jasobrino/sensores-MQTT/modulos lora/estacion/README.md

# sensores-MQTT
recopilación datos a través de mqtt
