jasobrino/sensores-MQTT/documentos/Schematic_ESP32 sensores MQTT rev. 1.2_2023-10-23.png

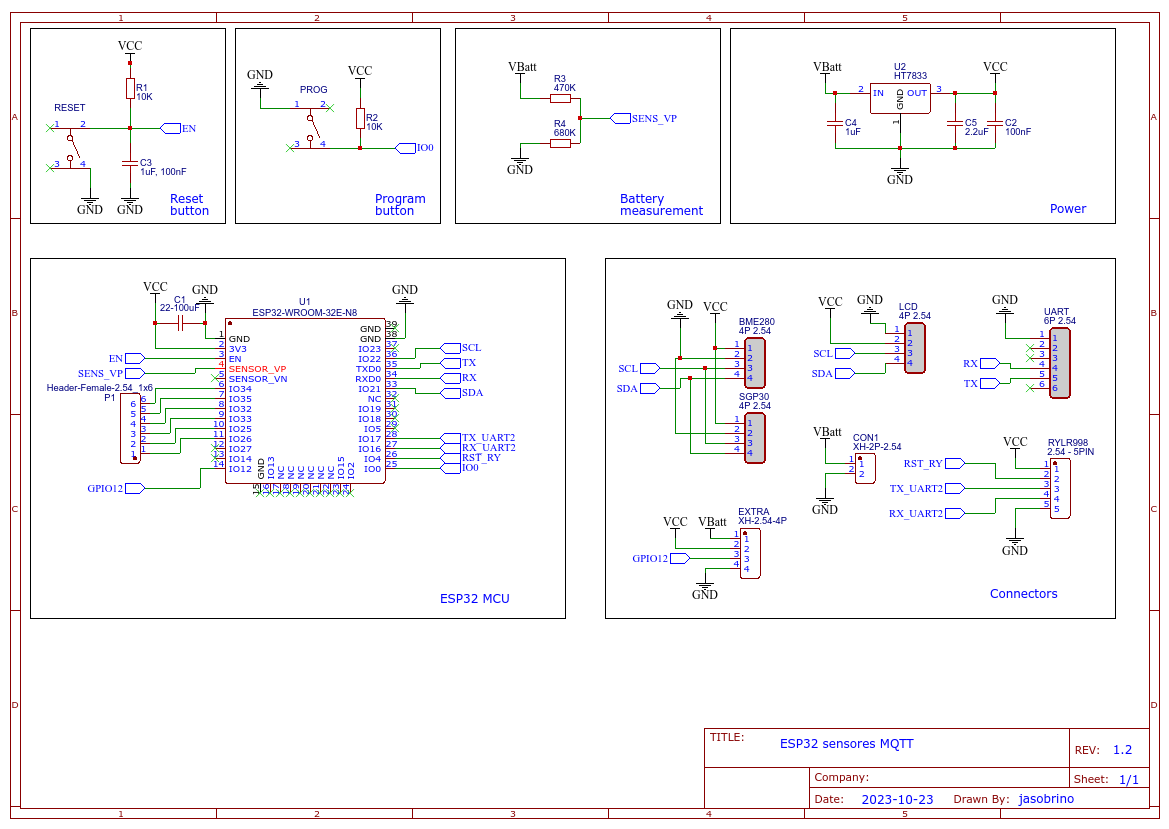
documentos/Schematic_ESP32 sensores MQTT rev. 1.2_2023-10-23.png
