jasobrino/sensores-MQTT/documentos/Gerber_PCB_ESP32 BME280 V1.0 2023-05-28/How-to-order-PCB.txt

How to Order PCB

Please refer to:
https://docs.easyeda.com/en/PCB/Order-PCB
