jasobrino/sensores-MQTT/documentos/datos_tester_rssi-57.pdf

Test Data

2023-05-09 16:33:21

1/8

No. | Date/Time | Function | Range | Value | Unit
1 | 2023-05-09 16:30:41 | DCA | 22 | 0.000 | A
2 | 2023-05-09 16:30:42 | DCA | 22 | 0.000 | A
3 | 2023-05-09 16:30:42 | DCA | 22 | 0.000 | A
4 | 2023-05-09 16:30:42 | DCA | 22 | 0.000 | A
5 | 2023-05-09 16:30:42 | DCA | 22 | 0.000 | A
6 | 2023-05-09 16:30:42 | DCA | 22 | 0.000 | A
7 | 2023-05-09 16:30:43 | DCA | 22 | 0.000 | A
8 | 2023-05-09 16:30:43 | DCA | 22 | 0.000 | A
9 | 2023-05-09 16:30:43 | DCA | 22 | 0.000 | A
10 | 2023-05-09 16:30:43 | DCA | 22 | 0.000 | A
11 | 2023-05-09 16:30:44 | DCA | 22 | 0.000 | A
12 | 2023-05-09 16:30:44 | DCA | 22 | 0.000 | A
13 | 2023-05-09 16:30:44 | DCA | 22 | 0.000 | A
14 | 2023-05-09 16:30:44 | DCA | 22 | 0.000 | A
15 | 2023-05-09 16:30:44 | DCA | 22 | 0.000 | A
16 | 2023-05-09 16:30:45 | DCA | 22 | 0.000 | A
17 | 2023-05-09 16:30:45 | DCA | 22 | 0.000 | A
18 | 2023-05-09 16:30:45 | DCA | 22 | 0.000 | A
19 | 2023-05-09 16:30:45 | DCA | 22 | 0.000 | A
20 | 2023-05-09 16:30:46 | DCA | 22 | 0.000 | A
21 | 2023-05-09 16:30:46 | DCA | 22 | 0.000 | A
22 | 2023-05-09 16:30:46 | DCA | 22 | 0.000 | A
23 | 2023-05-09 16:30:46 | DCA | 22 | 0.000 | A
24 | 2023-05-09 16:30:46 | DCA | 22 | 0.000 | A
25 | 2023-05-09 16:30:47 | DCA | 22 | 0.000 | A
26 | 2023-05-09 16:30:47 | DCA | 22 | 0.000 | A
27 | 2023-05-09 16:30:47 | DCA | 22 | 0.000 | A
28 | 2023-05-09 16:30:47 | DCA | 22 | 0.000 | A
29 | 2023-05-09 16:30:47 | DCA | 22 | 0.000 | A
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
481 | 2023-05-09 16:32:27 | DCA | 22 | 0.000 | A
482 | 2023-05-09 16:32:27 | DCA | 22 | 0.000 | A
483 | 2023-05-09 16:32:27 | DCA | 22 | 0.000 | A
484 | 2023-05-09 16:32:27 | DCA | 22 | 0.000 | A
485 | 2023-05-09 16:32:27 | DCA | 22 | 0.000 | A
486 | 2023-05-09 16:32:28 | DCA | 22 | 0.000 | A
487 | 2023-05-09 16:32:28 | DCA | 22 | 0.000 | A
488 | 2023-05-09 16:32:28 | DCA | 22 | 0.000 | A
489 | 2023-05-09 16:32:28 | DCA | 22 | 0.000 | A
490 | 2023-05-09 16:32:29 | DCA | 22 | 0.000 | A
491 | 2023-05-09 16:32:29 | DCA | 22 | 0.000 | A
492 | 2023-05-09 16:32:29 | DCA | 22 | 0.000 | A
493 | 2023-05-09 16:32:29 | DCA | 22 | 0.000 | A
494 | 2023-05-09 16:32:29 | DCA | 22 | 0.000 | A
495 | 2023-05-09 16:32:30 | DCA | 22 | 0.000 | A
496 | 2023-05-09 16:32:30 | DCA | 22 | 0.000 | A
497 | 2023-05-09 16:32:30 | DCA | 22 | 0.000 | A
498 | 2023-05-09 16:32:30 | DCA | 22 | 0.000 | A
499 | 2023-05-09 16:32:31 | DCA | 22 | 0.000 | A
500 | 2023-05-09 16:32:31 | DCA | 22 | 0.000 | A
