jasobrino/sensores-MQTT/(commit log)

2023-11-28 divido proyecto en receptor y estacion
    [Drill_NPTH_Through.DRL, Drill_PTH_Through.DRL, Drill_PTH_Through_Via.DRL, Gerber_BoardOutlineLayer.GKO, Gerber_BottomLayer.GBL, Gerber_BottomSilkscreenLayer.GBO, Gerber_BottomSolderMaskLayer.GBS, Gerber_TopLayer.GTL]
2023-12-07 modulo receptor - envío datos a broker mqtt
    [main.cpp]
2024-03-05 incluido servidor web interno para control de archivos
    [INFORMACION SENSORES Y CONSUMO.ods, valores baseline sensores SGP30.ods]
